YruamaLairba/midiUsbPedalboard/README.md

# midiUsbPedalboard

This project is to build a configurable midi USB footcontroller with 4
footswitch and 2 inputs for expression pedals. The project is splitted into
subprojects to address differents aspects.
