YruamaLairba/midiUsbPedalboard/enclosure/perfboard.stl

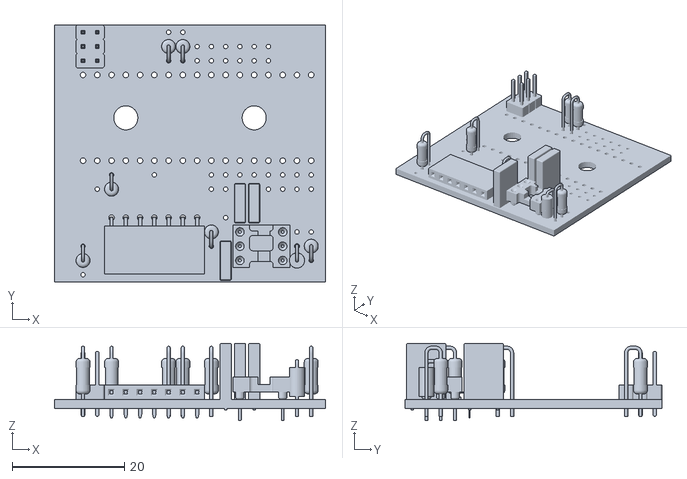
[picture p1: CAD file, 2019-08-28]
enclosure/perfboard.stl
48.3 x 45.7 x 13.8
