YruamaLairba/midiUsbPedalboard/enclosure/boitier_corner_bracket.scad

include <boitier_modules.scad>
corner_bracket();
