YruamaLairba/midiUsbPedalboard/enclosure/reinforcing.scad

include <boitier_modules.scad>
reinforcing();
