YruamaLairba/midiUsbPedalboard/perfboard/midiPedalboard_Perfboard.kicad_pcb

## KiCad design perfboard/midiPedalboard_Perfboard.kicad_pcb (2019-08-28)

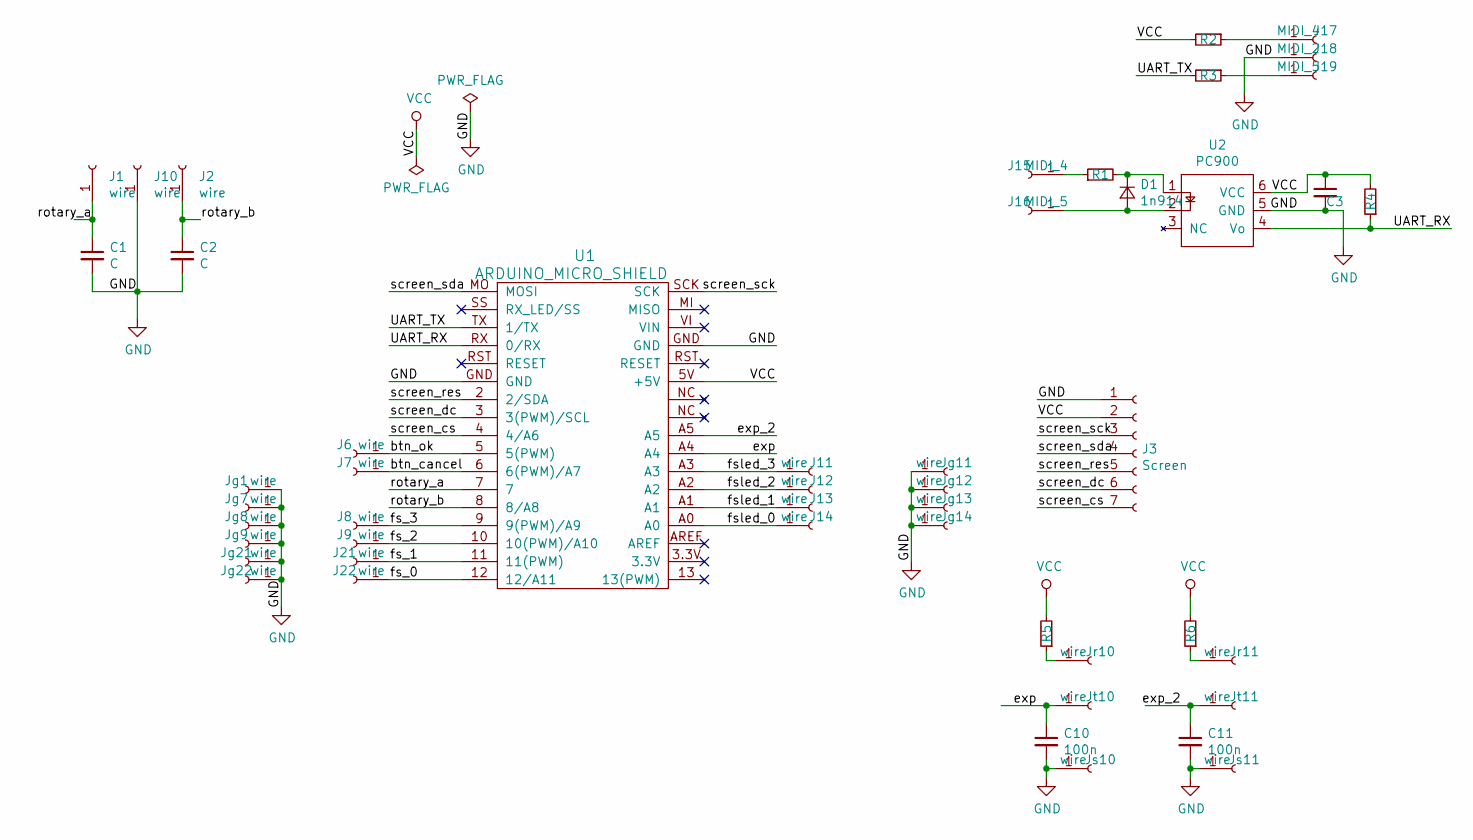
[picture p2: schematic midiPedalboard_Perfboard.sch]

Parts:
C1, C2: C; C_Rect_L7.0mm_W2.0mm_P5.00mm
C3: 0.1 uf; C_Rect_L7.0mm_W2.0mm_P5.00mm
C10, C11: 100n; C_Rect_L7.0mm_W2.0mm_P5.00mm
D1: 1n914; D_A-405_P2.54mm_Vertical_AnodeUp
J1, J2, J6, J7, J8, J9, J10, J11, J12, J13, J14, J21, J22: wire; SolderWirePad_1x01_Drill0.8mm
J3: Screen; PinSocket_1x07_P2.54mm_Horizontal
J15, J17: MIDI_4; SolderWirePad_1x01_Drill0.8mm
J16, J19: MIDI_5; SolderWirePad_1x01_Drill0.8mm
J18: MIDI_2; SolderWirePad_1x01_Drill0.8mm
Jg1, Jg7, Jg8, Jg9, Jg11, Jg12, Jg13, Jg14, Jg21, Jg22: wire; SolderWirePad_1x01_Drill0.8mm
Jr10, Jr11: wire; SolderWirePad_1x01_Drill0.8mm
Js10, Js11: wire; SolderWirePad_1x01_Drill0.8mm
Jt10, Jt11: wire; SolderWirePad_1x01_Drill0.8mm
R1, R2, R3: 220; R_Axial_DIN0207_L6.3mm_D2.5mm_P2.54mm_Vertical
R4: 280; R_Axial_DIN0207_L6.3mm_D2.5mm_P2.54mm_Vertical
R5, R6: 100; R_Axial_DIN0207_L6.3mm_D2.5mm_P2.54mm_Vertical
U1: ARDUINO_MICRO_SHIELD
U2: PC900; DIP-6_W7.62mm_Socket

Connections:
/UART_RX: R4.1, U1.RX (0/RX), U2.4 (Vo)
/UART_TX: R3.2, U1.TX (1/TX)
/btn_cancel: J7.1, U1.6 (6(PWM)/A7)
/btn_ok: J6.1, U1.5 (5(PWM))
/exp: C10.1, Jt10.1, U1.A4
/exp_2: C11.1, Jt11.1, U1.A5
/fs_0: J22.1, U1.12 (12/A11)
/fs_1: J21.1, U1.11 (11(PWM))
/fs_2: J9.1, U1.10 (10(PWM)/A10)
/fs_3: J8.1, U1.9 (9(PWM)/A9)
/fsled_0: J14.1, U1.A0
/fsled_1: J13.1, U1.A1
/fsled_2: J12.1, U1.A2
/fsled_3: J11.1, U1.A3
/rotary_a: C1.1, J1.1, U1.7
/rotary_b: C2.1, J2.1, U1.8 (8/A8)
/screen_cs: J3.7, U1.4 (4/A6)
/screen_dc: J3.6, U1.3 (3(PWM)/SCL)
/screen_res: J3.5, U1.2 (2/SDA)
/screen_sck: J3.3, U1.SCK
/screen_sda: J3.4, U1.MO (MOSI)
GND: C1.2, C2.2, C3.2, C10.2, C11.2, J3.1, J10.1, J18.1, Jg1.1, Jg7.1, Jg8.1, Jg9.1, Jg11.1, Jg12.1, Jg13.1, Jg14.1, Jg21.1, Jg22.1, Js10.1, Js11.1, U1.GND, U2.5 (GND)
unnamed: D1.1 (K), R1.2, U2.1
unnamed: D1.2 (A), J16.1, U2.2
unnamed: J15.1, R1.1
unnamed: J17.1, R2.1
unnamed: J19.1, R3.1
unnamed: Jr10.1, R5.1
unnamed: Jr11.1, R6.1
VCC: C3.1, J3.2, R2.2, R4.2, R5.2, R6.2, U1.5V (+5V), U2.6 (VCC)

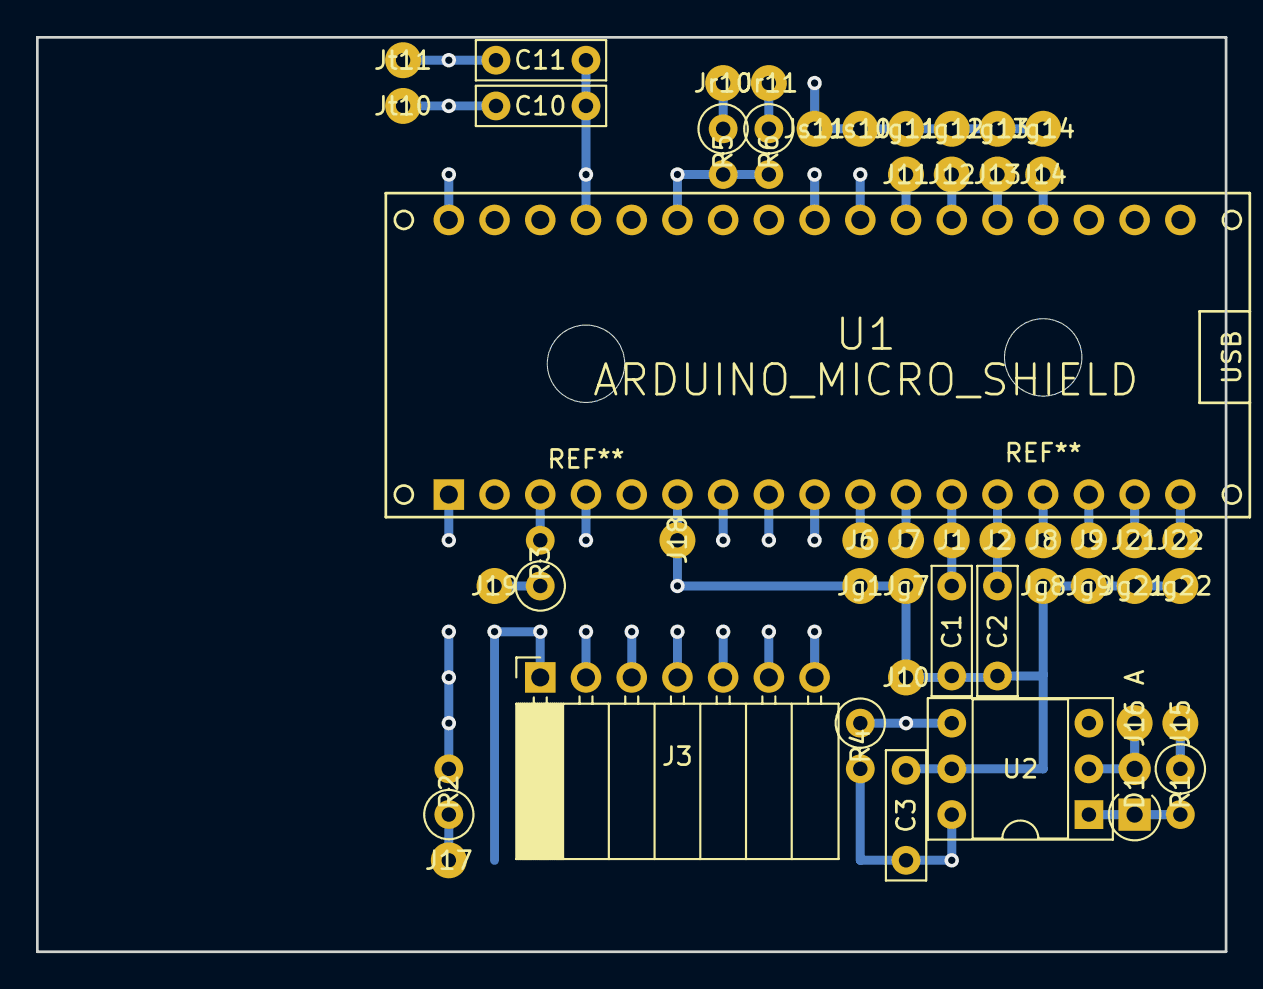
[picture p3: board midiPedalboard_Perfboard.kicad_pcb from above]

Board: 8 copper layers, 66.0 x 50.8 mm, 49 parts (0 on the bottom side), 30 nets.
