YruamaLairba/midiUsbPedalboard/firmware/midiPedalboard/eeprom_config.h

#ifndef EEPROM_CONFIG_H
#define EEPROM_CONFIG_H

//eeprom mapping
//memory address
const unsigned int eeprom_midi_channel_start = 0;
const unsigned int eeprom_exp_cal_start = 4;
const unsigned int eeprom_preset_number_start = 31;
const unsigned int eeprom_preset_bank_start = 32;
const unsigned int eeprom_preset_bank_end = E2END;


#endif //EEPROM_CONFIG_H
