YruamaLairba/midiUsbPedalboard/(commit log)

2017-05-14 Creating a class prototype for the "mainConf" menu
2017-08-03 fix makefile, use of arduino 1.8.3
2017-08-09 fs now send message, led feedback...
    but led feedback is sensless with "single mode"
2017-08-10 deboucing protoype on Ok et CANCEl button
2017-09-06 fix a typo in a header guard
    [display.h]
2017-09-07 improve the way leds lit depending on fsConfig
2017-09-14 start project with a draft
    [boitier_brouillon.scad]
2017-09-14 swap x and y coordinate
    [boitier_brouillon.scad]
2017-09-20 Some ajustement :p
    [boitier_brouillon.scad]
2017-09-20 Create module for fooswitch
    [footswitch.scad]
2017-09-27 better looking footswitch
    [footswitch.scad]
2017-09-27 use module for each part of the box.
    and each art are builded from an extruded 2D shape
    [boitier_brouillon.scad]
2017-09-27 create 2 finger between low_top and sides
    [boitier_brouillon.scad]
2017-09-27 use a variable for thickness
    [boitier_brouillon.scad]
2017-09-27 create finger beetween low_top and low_front
    [boitier_brouillon.scad]
2017-09-27 use variable for step height
    [boitier_brouillon.scad]
2017-09-27 Create finger between low_front and sides
    [boitier_brouillon.scad]
2017-09-27 create finger between high_front and sides
    [boitier_brouillon.scad]
2017-09-27 create fingers between rear and sides
    [boitier_brouillon.scad]
2017-09-27 using var for finger between low_front and low top
    [boitier_brouillon.scad]
2017-09-27 add finger between high_front et high_top
    [boitier_brouillon.scad]
2017-09-27 create finger between rear and high_top
    [boitier_brouillon.scad]
2017-09-27 create fingers between high_top and sides
    [boitier_brouillon.scad]
2017-09-27 create finger between low_top and high front
    [boitier_brouillon.scad]
2017-09-27 change fs design to avoid bug with difference
    [footswitch.scad]
2017-09-27 put all footswitch as background element
    [boitier_brouillon.scad]
2017-09-28 design already existing angle bracket
    [angle_bracket.scad]
2017-09-28 add ngle bracket as background element
    [boitier_brouillon.scad]
2017-09-28 use var to adjust distance between fs and sides
    [boitier_brouillon.scad]
2017-10-04 create bottom
    [boitier_brouillon.scad]
2017-10-04 bug fix + angle bracket for bottom
    [boitier_brouillon.scad]
2017-10-11 fix typo, change rear angle bracket and leds hole
    [boitier_brouillon.scad]
2017-10-11 add hole for cable.
    [boitier_brouillon.scad]
2017-10-12 fix error one angle bracket hole
    [angle_bracket.scad]
2017-10-12 refactoring, separate module in 2D and 3D shape
    [boitier_brouillon.scad]
2017-10-12 add block for a 2D export
    [boitier_brouillon.scad]
2018-02-08 add holes diameter
    [boitier_brouillon.scad]
2018-02-08 fix an error causing glitch in preview
    [boitier_brouillon.scad]
2018-02-08 add/change size for screw of screen
    [boitier_brouillon.scad]
2018-02-08 remake opening/hole for screen
    [boitier_brouillon.scad]
2018-04-26 add M4 holes to low_top
    [boitier_brouillon.scad]
2018-04-26 add M4 holes to low_front
    [boitier_brouillon.scad]
2018-04-26 add m4 holes to the high_front
    [boitier_brouillon.scad]
2018-04-26 add M4 holes to rear
    [boitier_brouillon.scad]
2018-04-26 add M4 holes to left
    [boitier_brouillon.scad]
2018-04-26 add M4 holes to right
    [boitier_brouillon.scad]
2018-04-26 add M4 holes to bottom
    [boitier_brouillon.scad]
2018-04-26 rearrange high_top code
    [boitier_brouillon.scad]
2018-05-02 add M4 holes on high top
    [boitier_brouillon.scad]
2018-05-02 replace 4 angle_bracket_simple with 2 angle_bracket_double
    [boitier_brouillon.scad]
2018-05-02 adjust holes for double angle brackets
    [boitier_brouillon.scad]
2018-05-02 duplicat some bracket
    [boitier_brouillon.scad]
2018-05-03 add or chnage some bracket
    [boitier_brouillon.scad]
2018-05-03 adjust M4 holes on high top
    [boitier_brouillon.scad]
2018-05-03 adjust M4 holes on low_top
    [boitier_brouillon.scad]
2018-05-03 adjust M4 holes on low front
    [boitier_brouillon.scad]
2018-05-03 adjust M4 holes on high front and change hole for cable
    [boitier_brouillon.scad]
2018-05-06 add some M4 holes to rear
    [boitier_brouillon.scad]
2018-05-06 change some M4 holes to left
    [boitier_brouillon.scad]
2018-05-06 change some M4 holes of right panel
    [boitier_brouillon.scad]
2018-06-21 draft, Footswitch::read jut do momentary switch
2018-07-25 fix an error on preset adresse, save last preset
    [eeprom_config.h, midiPedalboard.ino]
2018-08-01 put selection on the current preset in menus
2018-08-09 fix no fs led lighting when preset load on startup
    [midiPedalboard.ino]
2018-08-11 enclose Arduino lib header to avoid warnings from them
    [display.h, exp_pedal.cpp, exp_pedal.h, footswitch.cpp, footswitch.h, midiPedalboard.ino, rotary_encoder.h, setup.h]
2018-08-15 use a clas to handle ok and cancel button
2018-08-16 remove some Serial.printing crap
2018-08-19 fix a bug on debouncing
    [push_button.cpp]
2018-08-22 fix void instead uint8_t on accessor
    [controller_system.cpp, controller_system.h]
2018-08-24 fix a warning in push_button
    [push_button.cpp]
2018-08-24 fix warningis about narrowing conversion
    [exp_pedal.cpp, footswitch.cpp]
2018-08-24 fix warning about sign conversion
    [controller_system.cpp]
2018-08-25 implment reverse mode for exp_pedal
    [exp_pedal.cpp]
2018-08-29 add clearance for midi and usb connector
    [USB_connector.scad, boitier_brouillon.scad, midi_connector.scad]
2018-08-29 split files for modules, preview, and export
    [boitier_2D.scad, boitier_3D.scad, boitier_brouillon.scad]
2018-08-29 remove 3D view from modules file
    [boitier_brouillon.scad]
2018-08-30 rename files
    [boitier_2D_export.scad, boitier_3D_preview.scad, boitier_modules.scad]
2018-08-30 remove platic cover
    [boitier_3D_preview.scad, boitier_modules.scad]
2018-08-30 put connector placeholder in 3D view
    [boitier_3D_preview.scad, boitier_modules.scad]
2018-08-30 put footswitch in 3D preview
    [boitier_3D_preview.scad, boitier_modules.scad]
2018-08-30 put angle bracket in 3D preview
    [boitier_3D_preview.scad, boitier_modules.scad]
2018-08-30 remove some useless commented code
    [boitier_modules.scad]
2019-02-25 keep only a skeleton and some usefull modules
    [boitier_2D_export.scad, boitier_3D_preview.scad, boitier_modules.scad]
2019-02-25 create top with screen, Fs, and leds holes
    [boitier_3D_preview.scad, boitier_modules.scad]
2019-02-25 add fingers to the top
    [boitier_modules.scad]
2019-02-25 improve fingers
    [boitier_modules.scad]
2019-02-27 start front panel, fix invert option of finger mod
    [boitier_3D_preview.scad, boitier_modules.scad]
2019-02-27 add left panel (/!\ collision)
    [boitier_3D_preview.scad, boitier_modules.scad]
2019-02-27 add fingers between front and left (solve collision)
    [boitier_modules.scad]
2019-02-27 add rear panel without connector clearance
    [boitier_3D_preview.scad, boitier_modules.scad]
2019-02-27 add right panel
    [boitier_3D_preview.scad, boitier_modules.scad]
2019-02-27 add bottom panel
    [boitier_3D_preview.scad, boitier_modules.scad]
2019-02-27 add connector hole and clearance
    [boitier_3D_preview.scad, boitier_modules.scad]
2019-02-27 parametrize finger size
    [boitier_modules.scad]
2019-02-27 add Footswitch and connector to preview
    [boitier_3D_preview.scad]
2019-02-28 add M4 hole
    [boitier_modules.scad]
2019-02-28 create a crappy parametrizable angle bracket
    [custom_angle_bracket.scad]
2019-02-28 use ma_bracket in the preview
    [boitier_3D_preview.scad]
2019-03-06 fix copy paste error
    [custom_angle_bracket.scad]
2019-03-06 put corner bracket, work around to have transparency view
    [boitier_3D_preview.scad]
2019-03-06 create a proxy modul for screw
    [boitier_3D_preview.scad]
2019-03-06 add screw in preview
    [boitier_3D_preview.scad]
2019-03-06 change variable for M4 screw positionning
    [boitier_3D_preview.scad, boitier_modules.scad]
2019-03-06 create corner bracket module
    [boitier_modules.scad]
2019-03-06 put new corner bracket in the preview instead
    [boitier_3D_preview.scad]
2019-03-06 completly remove the old angle bracket
    [boitier_3D_preview.scad, custom_angle_bracket.scad]
2019-03-07 have file to export in dxf for lazer cutting
    [boitier_2D_export.scad]
2019-03-13 add hole for exp pedal connector
    [boitier_modules.scad]
2019-03-14 parametrise connector pos
    [boitier_3D_preview.scad, boitier_modules.scad]
2019-03-14 parametrize jack hole position for exp pedal
    [boitier_modules.scad]
2019-03-14 oops, forgot a cut/copy/paste
    [boitier_modules.scad]
2019-03-20 move connector position (avoid collision)
    [boitier_modules.scad]
2019-03-20 fix usb connector and color external element
    [boitier_3D_preview.scad]
2019-03-20 file juste for export corner_bracket
    [boitier_corner_bracket.scad]
2019-03-20 use rean drawing spec for midi holes
    [boitier_modules.scad]
2019-03-27 use recommended tape drill dimension for M4
    [boitier_modules.scad]
2019-04-21 last fix and adjustment to allow pgm send
    [controller_system.cpp, controller_system.h, footswitch.cpp, menu_system.cpp]
2019-04-21 add missings cases in switch
    [footswitch.cpp]
2019-05-01 swap screen connectors to one connectors
    [_saved_midiPedalboard_Perfboard.sch, midiPedalboard_Perfboard.kicad_pcb]
2019-05-01 move hole, connect everything
    [midiPedalboard_Perfboard.kicad_pcb]
2019-05-01 add a second exp pedal input
    [_saved_midiPedalboard_Perfboard.sch, midiPedalboard_Perfboard.kicad_pcb, midiPedalboard_Perfboard.sch]
2019-05-02 some placment and connection
    [midiPedalboard_Perfboard.kicad_pcb, midiPedalboard_Perfboard.sch]
2019-05-02 rotate the design
    [midiPedalboard_Perfboard.kicad_pcb]
2019-05-02 relayout and connection
    [midiPedalboard_Perfboard.kicad_pcb, midiPedalboard_Perfboard.sch]
2019-05-02 move pc900 part
    [midiPedalboard_Perfboard.kicad_pcb]
2019-05-02 move sticker
    [midiPedalboard_Perfboard.kicad_pcb]
2019-05-08 move sticker 2
    [midiPedalboard_Perfboard.kicad_pcb]
2019-05-16 perfboard hole mounting and display perfboard
    [boitier_3D_preview.scad, boitier_modules.scad, perfboard.stl]
2019-05-16 adjust jack hole,jack proxy , move conncetors
    [boitier_3D_preview.scad, boitier_modules.scad, jack_connector.scad]
2019-05-20 create and place reinforcing bracket
    [boitier_3D_preview.scad, boitier_modules.scad, reinforcing.scad]
2019-05-20 reinforcment more parametrizable & M4 holes
    [boitier_3D_preview.scad, boitier_modules.scad]
2019-05-20 screw for reinforcement and perfboard in 3D preview
    [boitier_3D_preview.scad]
2019-05-20 adjust reinforcement to avoid issue with buttons
    [boitier_modules.scad]
2019-05-20 fix a calculation error for reinforcment hole on the rear
    [boitier_3D_preview.scad, boitier_modules.scad]
2019-05-20 better jack connector proxy
    [jack_connector.scad]
2019-05-20 moving connector and reinforcing & second jack input
    [boitier_3D_preview.scad, boitier_modules.scad]
2019-07-04 fix internal rst wire
    [midiPedalboard_Perfboard.kicad_pcb]
2019-07-04 condensator for adc filtering
    [midiPedalboard_Perfboard.kicad_pcb, midiPedalboard_Perfboard.sch]
2019-07-07 revert order of fs pin to reflect what i really did
    [_saved_midiPedalboard_Perfboard.sch, midiPedalboard_Perfboard.kicad_pcb, midiPedalboard_Perfboard.sch]
2019-07-31 ooops, fs connection order was reverted
    [setup.h]
2019-07-31 reset footswitch when cmd_typ change to avoid inconsistensy
    [footswitch.cpp, footswitch.h, menu_system.cpp]
2019-08-07 implement pitch bend on exp_pedal
2019-08-08 menu to select exp to calibrate
2019-08-08 menu root to calibrate a exp_pedal
2019-08-11 menu for toes calibration, print the raw exp value
    need to redesign menu system to refresh regularly this menu
    [controller_system.cpp, controller_system.h, exp_pedal.cpp, exp_pedal.h, menu_system.cpp, menu_system.h]
2019-08-11 MneuExpCalSel, fix displayed number of exp pedal
    [menu_system.cpp]
2019-08-11 create accessors for exp pedal calibrations
2019-08-11 load/store in eeprom exp calibration (compile but untested)
2019-08-11 heel pos calibration can now be set from menu
    need to fix a visual glitch
    [menu_system.cpp, menu_system.h]
2019-08-11 fix display glitch in some menu
    [menu_system.cpp]
2019-08-11 make calibration really effective
2019-08-11 avoid to send same mesage twice,
    and fix a potential overflow when mapping value for pb
    [exp_pedal.cpp, exp_pedal.h]
2019-08-12 differenciate exp pedal for exp_refresh
    doesn't work when using arduino makefile
    [menu_system.cpp, menu_system.h]
2019-08-28 remove a unused file
    [angle_bracket.scad, boitier_3D_preview.scad]
2019-09-04 replace the lib but screen now flickering
    [display.h, menu_system.cpp, menu_system.h, midiPedalboard.ino]
2019-09-04 directly fully overwrite screen to avoid flicker
    [menu_system.cpp]
